lukasloetkolben/OpenRelay/README.md

# Opensource harness box / relay for Openpilot

**_Note:_**  the device has been tested and works perfectly!

If you have any questions contact me on Discord: loetkolben#2962

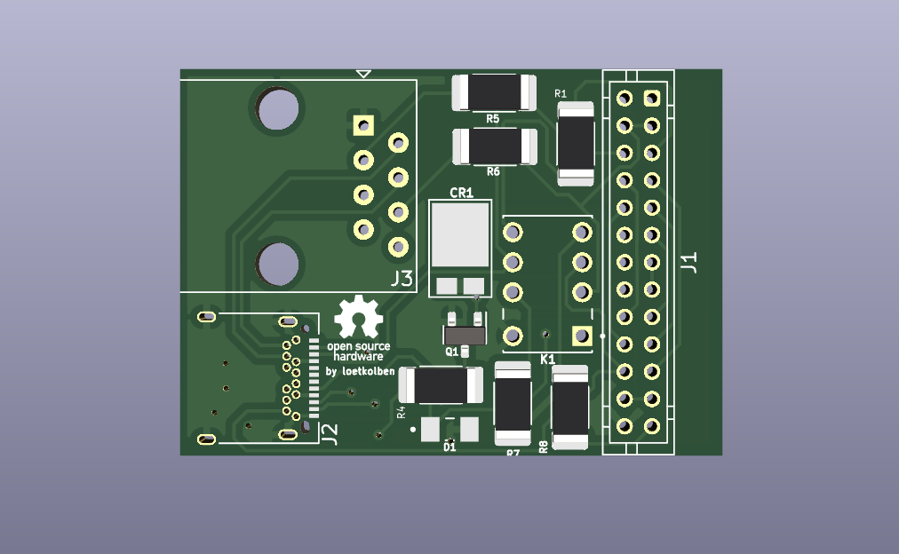
[picture p1: docs/topview.png]
