lukasloetkolben/OpenRelay/kicad_project/Relay.3d/BAV21W_RHG.step

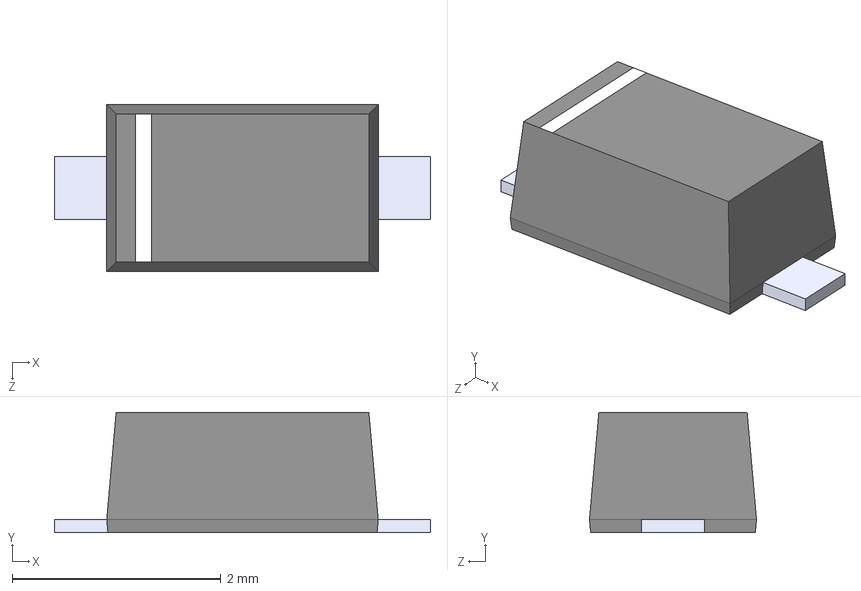
[picture p2: CAD file, 2022-05-26]
kicad_project/Relay.3d/BAV21W_RHG.step
3.60 x 1.15 x 1.60 mm
