lukasloetkolben/OpenRelay/kicad_project/Relay.step

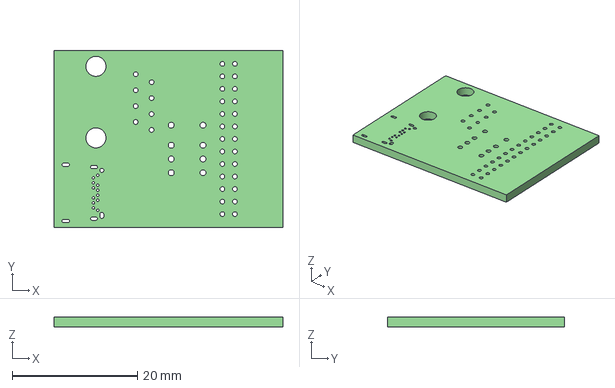
[picture p3: CAD file, 2022-06-27]
kicad_project/Relay.step
36.6 x 28.3 x 1.60 mm
