lukasloetkolben/OpenRelay/kicad_project/Relay.3d/G6K-2P-Y_DC3.step

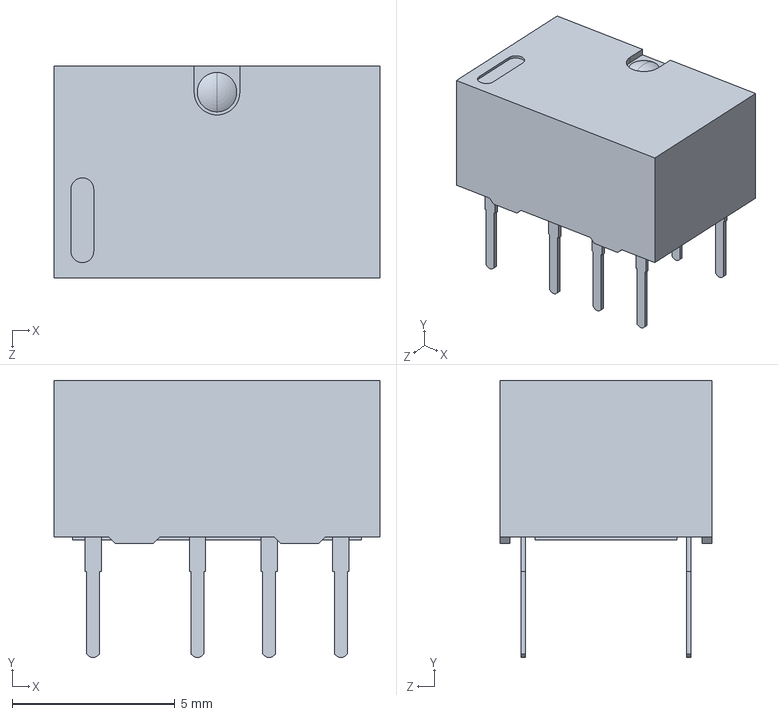
[picture p4: CAD file, 2022-05-26]
kicad_project/Relay.3d/G6K-2P-Y_DC3.step
10.0 x 8.50 x 6.50 mm
