lukasloetkolben/OpenRelay/kicad_project/Relay.3d/FSV20100V.step

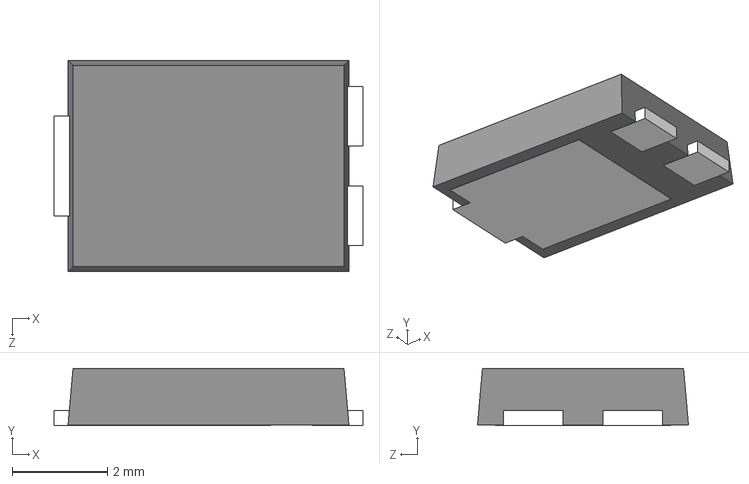
[picture p5: CAD file, 2022-05-26]
kicad_project/Relay.3d/FSV20100V.step
6.50 x 1.20 x 4.44 mm
