lukasloetkolben/OpenRelay/kicad_project/Relay.kicad_pcb

## KiCad design kicad_project/Relay.kicad_pcb (2022-06-27)

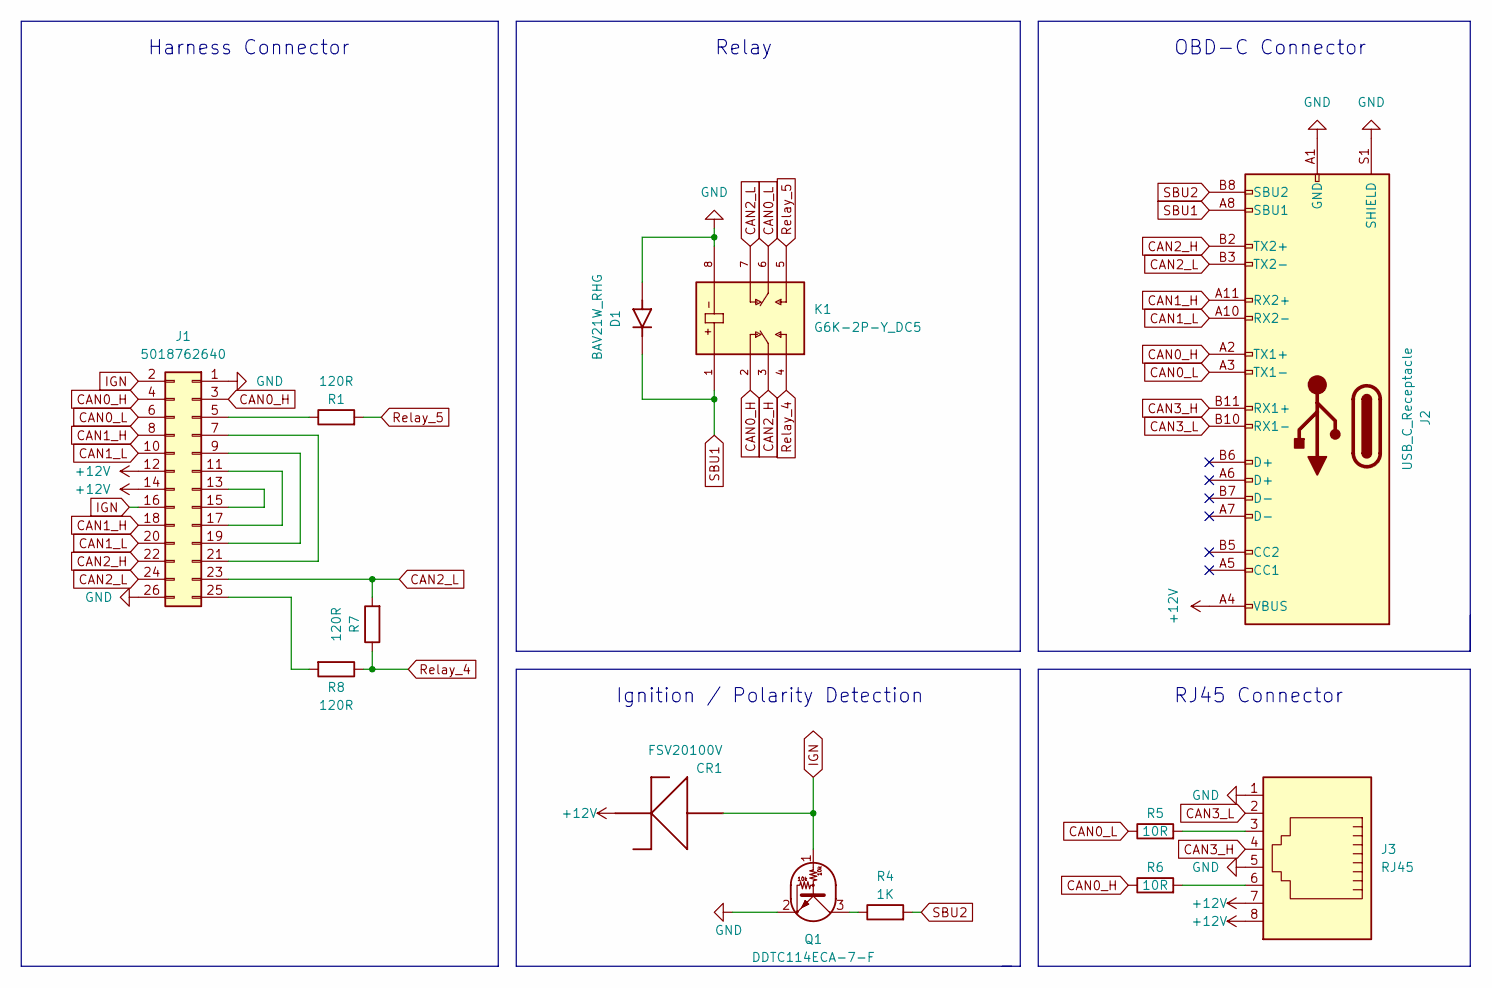
[picture p6: schematic Relay.kicad_sch, OBD-C Relay]

Parts:
CR1: FSV20100V; TO-277; PARTNO FSV20100VCT-ND
D1: BAV21W_RHG; DIO_BAV21W_RHG; PARTREV K1804
J1: 5018762640; JST_PHD_B26B-PHDSS_2x13_P2.00mm_Vertical
J2: USB_C_Receptacle; TYPE-C-31-M-04
J3: RJ45; RJ45_Amphenol_54602-x08_Horizontal
K1: G6K-2P-Y_DC5; RELAY_G6K-2P-Y_DC3; PARTREV K106-E1-11
Q1: DDTC114ECA-7-F; SOT-23
R1, R7, R8: 120R; R_2010_5025Metric_Pad1.40x2.65mm_HandSolder
R4: 1K; R_2010_5025Metric_Pad1.40x2.65mm_HandSolder
R5, R6: 10R; R_0603_1608Metric

Connections:
+12V: CR1.3, J1.12, J1.14, J2.A4 (VBUS), J2.A9 (VBUS), J2.B4 (VBUS), J2.B9 (VBUS), J3.7, J3.8
CAN0_H: J1.3, J1.4, J2.A2 (TX1+), K1.2, R6.1
CAN0_L: J1.6, J2.A3 (TX1-), K1.6, R5.1
CAN1_H: J1.8, J1.18, J2.A11 (RX2+)
CAN1_L: J1.10, J1.20, J2.A10 (RX2-)
CAN2_H: J1.22, J2.B2 (TX2+), K1.3
CAN2_L: J1.23, J1.24, J2.B3 (TX2-), K1.7, R7.2
CAN3_H: J2.B11 (RX1+), J3.4
CAN3_L: J2.B10 (RX1-), J3.2
GND: D1.A, J1.1, J1.26, J2.31, J2.32, J2.33, J2.34, J2.A1 (GND), J2.A12 (GND), J2.B1 (GND), J2.B12 (GND), J2.S1 (SHIELD), J3.1, J3.5, K1.8, Q1.2 (E)
IGN: CR1.1, CR1.2, J1.2, J1.16, Q1.1 (B)
unnamed: J1.5, R1.1
unnamed: J1.11, J1.17
unnamed: J1.13, J1.15
unnamed: J1.9, J1.19
unnamed: J1.7, J1.21
unnamed: J1.25, R8.2
unnamed: J3.3, R5.2
unnamed: J3.6, R6.2
unnamed: Q1.3 (C), R4.1
Relay_4: K1.4, R7.1, R8.1
Relay_5: K1.5, R1.2
SBU1: D1.C, J2.A8 (SBU1), K1.1
SBU2: J2.B8 (SBU2), R4.2

Notes on the sheet:
Harness Connector
Ignition / Polarity Detection
OBD-C Connector
RJ45 Connector
Relay

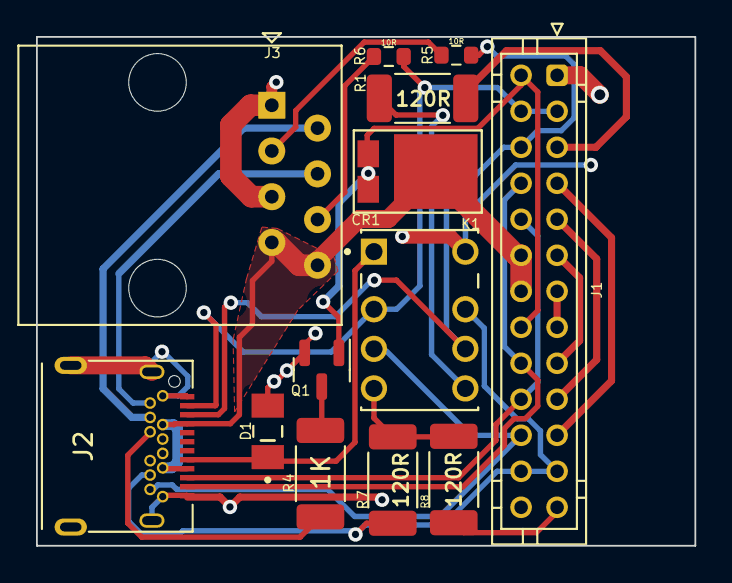
[picture p7: board Relay.kicad_pcb from above]

Board: 2 copper layers, 36.6 x 28.3 mm, 13 parts (0 on the bottom side), 24 nets.
