lukasloetkolben/OpenRelay/(threads)

Thread 2 (2022-05-30):

Q1 will stop IGN input from going high

EidoJ, 2022-05-30:
I haven't looked at the project files, only the docs/OpenRelay.pdf schematic.
The inherent base-collector diode in the BJT will conduct to ground, causing the IGN input to not be allowed to go high.

lukasloetkolben, 2022-05-30:
Sorry you are right, i will update it later!

EidoJ, 2022-05-30:
I don't have KiCAD on my phone at the moment. Perhaps the KiCAD schematic symbol feet numbers are also swapped to account for the mismatch.

Closed 2022-06-06.
