lukasloetkolben/OpenRelay/(commit log)

2022-05-26 BOM and OSHW Logo
    [OpenRelay_BOM.csv, Relay.kicad_pcb]
2022-05-27 added two more 12V vias
    [Relay.kicad_pcb]
2022-05-27 thicker ignition line
    [Relay.kicad_pcb]
2022-05-28 5V Relay not 3V
    [OpenRelay_BOM.csv, Relay.kicad_pcb]
2022-05-28 symbol SO2222 updated Symbol
    [Relay.kicad_pcb, Relay.kicad_sch]
2022-06-06 new NPN Transistor
    [Relay.kicad_pcb, Relay.kicad_sch]
2022-06-11 back to SO2222 NPN Transistor
    [OpenRelay_BOM.csv, Relay.kicad_pcb, Relay.kicad_sch]
2022-06-12 finally fixed Transistor Issue. credits to mlocoteta
    [BOM-Relay.csv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]
2022-06-12 schematics improvements. credits to mlocoteta
    [Relay.kicad_sch]
2022-06-27 update usb-c and pcb
    [BOM-Relay.csv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]
2023-03-18 updated BOM file for JLC
    [BOM-Relay.csv]
